csteber02/ECE-445/Final Project V1/CL21B105KBFNNNG/CL21B105KBFNNNG.step

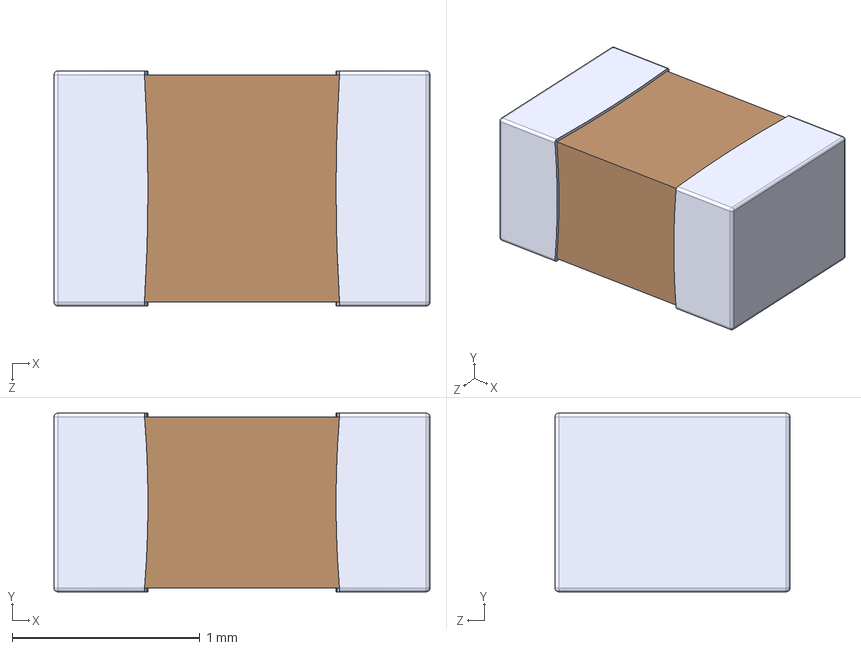
[picture p8: CAD file, 2025-02-24]
Final Project V1/CL21B105KBFNNNG/CL21B105KBFNNNG.step
2.00 x 0.95 x 1.25 mm
