csteber02/ECE-445/Final Project V1/Final Project V1.step

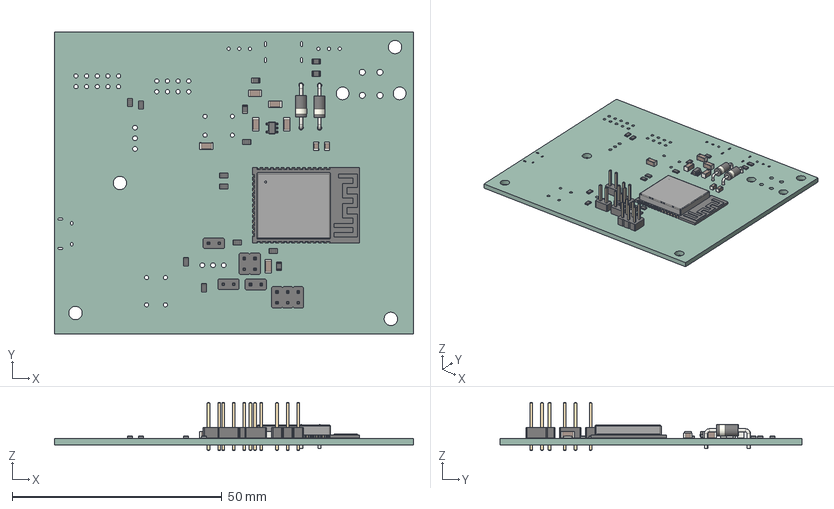
[picture p9: CAD file, 2025-04-11]
Final Project V1/Final Project V1.step
85.6 x 72.0 x 11.5 mm
D_DO-41_SOD81_P10.16mm_Horizontal x 2
R_0805_2012Metric x 14
ESP32-S3-WROOM-1
C_1206_3216Metric x 6
PinHeader_2x02_P254mm_Vertical
C_0805_2012Metric x 2
PinHeader_2x03_P254mm_Vertical
PinHeader_2x01_P254mm_Vertical x 3
SOT_23_5
Final Project V1_PCB
