csteber02/ECE-445/Final Project V1/UJC_HP_3_SMT_TR/UJC-HP-3-SMT-TR.step

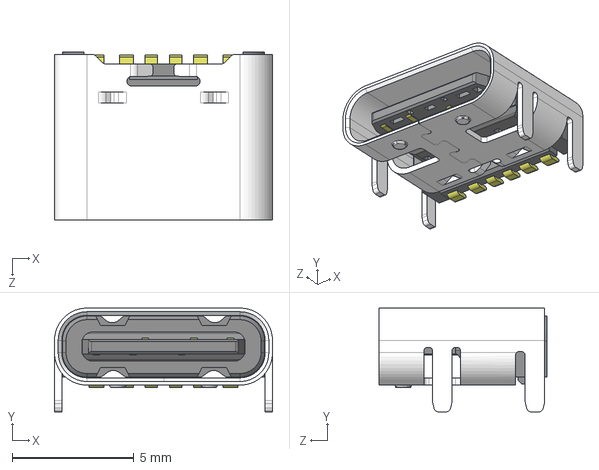
[picture p10: CAD file, 2025-02-27]
Final Project V1/UJC_HP_3_SMT_TR/UJC-HP-3-SMT-TR.step
8.94 x 4.26 x 6.90 mm
