csteber02/ECE-445/Final Project V1/Fish Feeder Rotator.stl

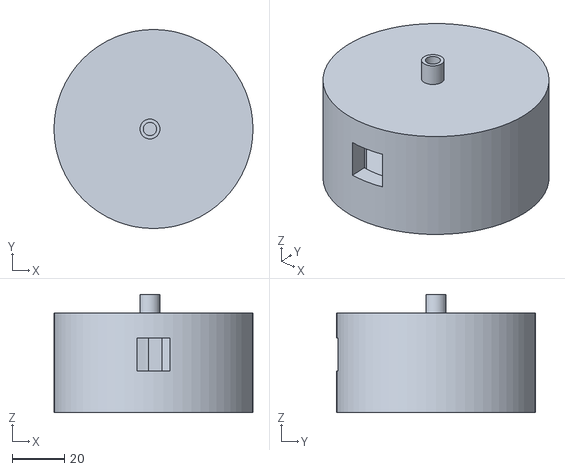
[picture p11: CAD file, 2025-03-10]
Final Project V1/Fish Feeder Rotator.stl
76.2 x 76.2 x 45.3
