csteber02/ECE-445/Final Project V1/10118194_0001LF/10118194-0001LF.step

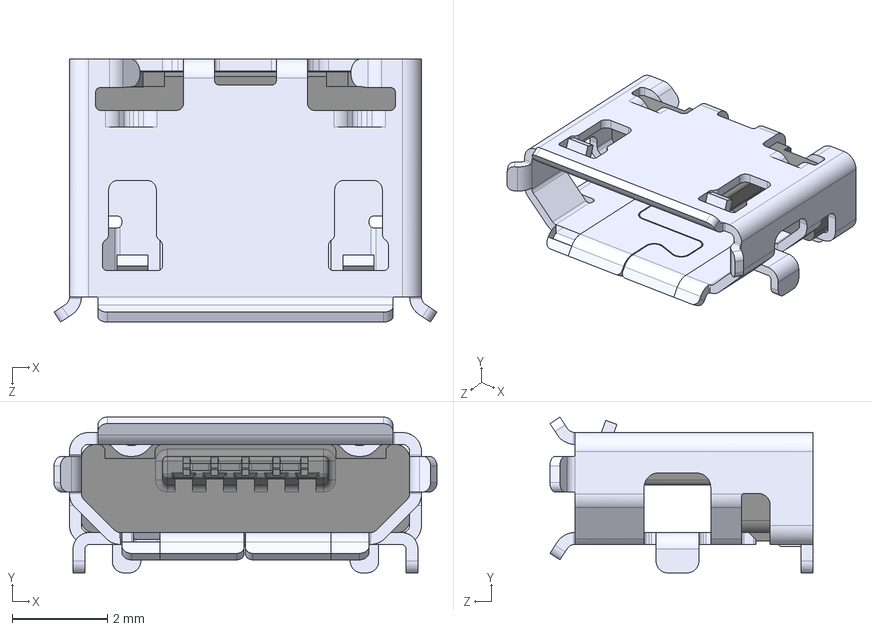
[picture p12: CAD file, 2025-04-11]
Final Project V1/10118194_0001LF/10118194-0001LF.step
8.05 x 3.27 x 5.53 mm
