csteber02/ECE-445/Final Project V1/1825910_6/1825910-6.step

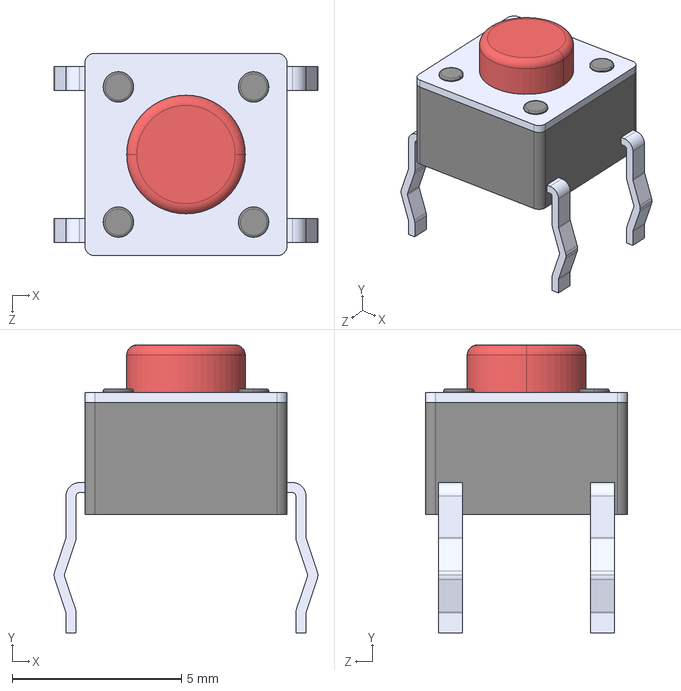
[picture p13: CAD file, 2025-03-10]
Final Project V1/1825910_6/1825910-6.step
7.80 x 8.52 x 5.99 mm
