csteber02/ECE-445/Final Project V1/75867_132LF/75867-132LF.step

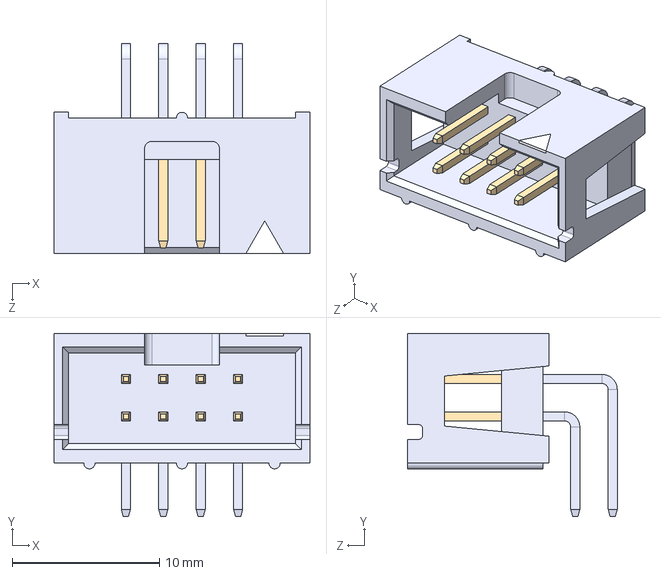
[picture p14: CAD file, 2025-03-28]
Final Project V1/75867_132LF/75867-132LF.step
17.4 x 12.5 x 14.2 mm
75867-xxxxLF_(Additional)_75867-132LF
Gold_Contact x 4
