csteber02/ECE-445/Final Project V1/BQ21040DBVR/BQ21040DBVR.step

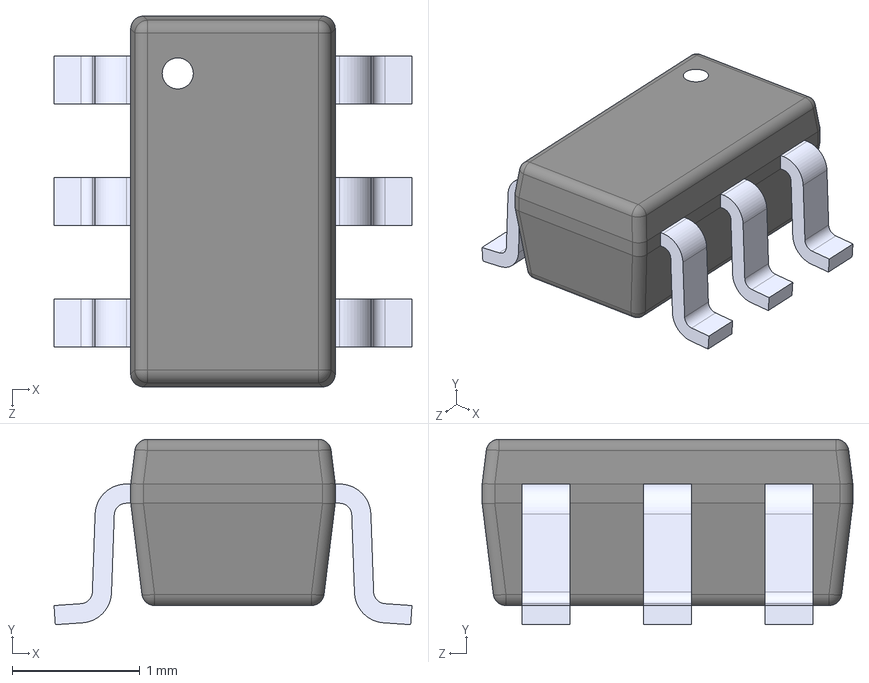
[picture p15: CAD file, 2025-02-27]
Final Project V1/BQ21040DBVR/BQ21040DBVR.step
2.80 x 1.45 x 2.90 mm
