csteber02/ECE-445/Final Project V1/TLV75533PDBVR/TLV75533PDBVR.step

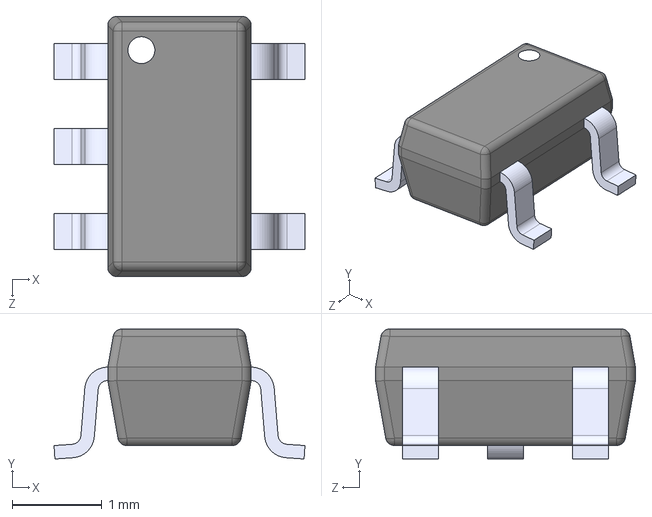
[picture p16: CAD file, 2025-02-24]
Final Project V1/TLV75533PDBVR/TLV75533PDBVR.step
2.80 x 1.45 x 2.90 mm
