csteber02/ECE-445/Lab Notebooks/Jeremy Notebook.pdf

1/27/2025

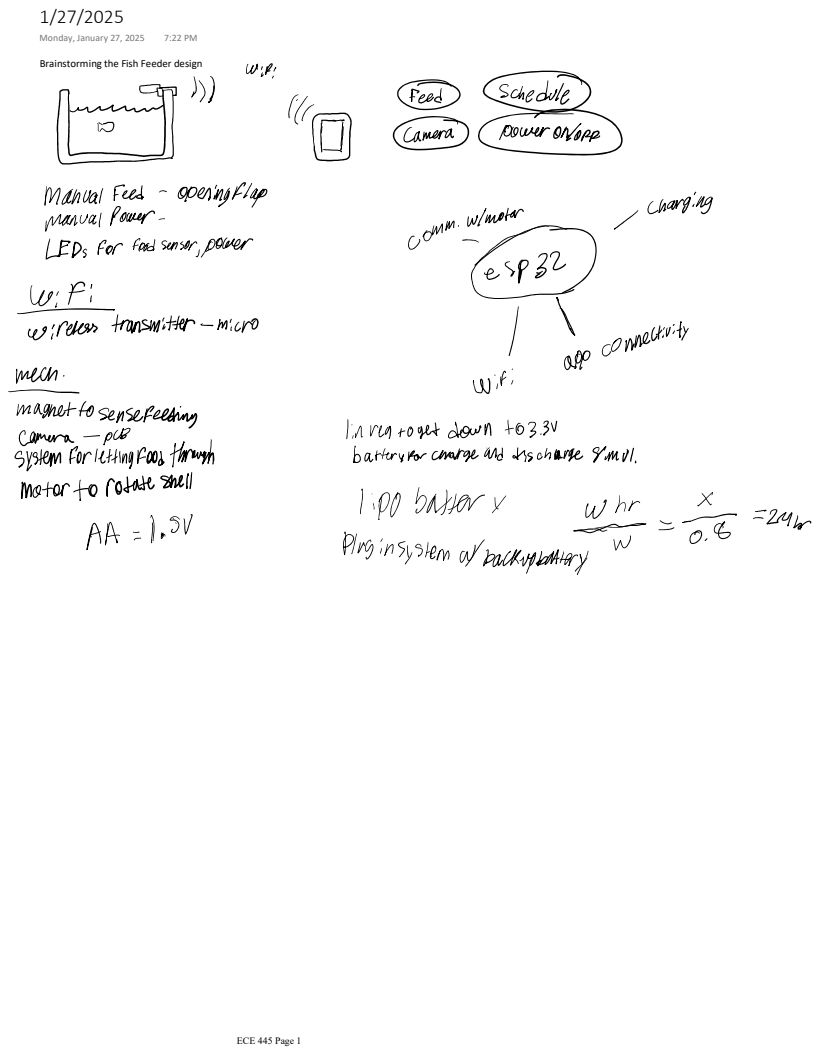
[picture p17: page 1]
Monday, January 27, 2025; ECE 445 Page 1

Brainstorming the Fish Feeder design

# 2/10/2025 - 5PM to 7PM

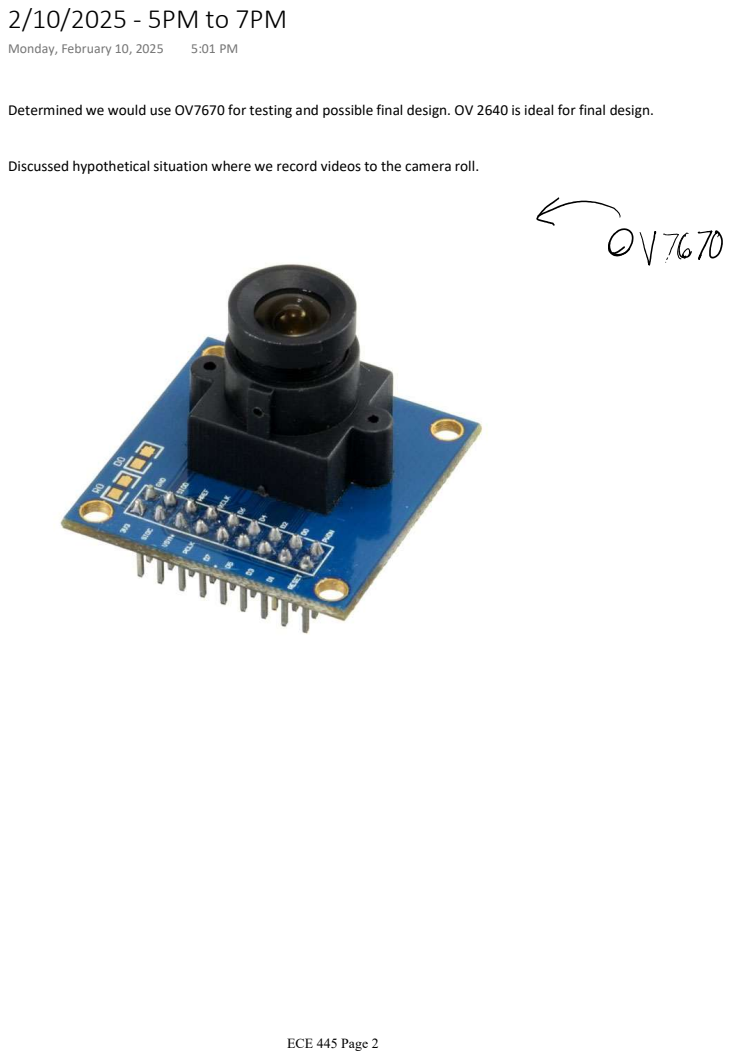
[picture p18: page 2]
Monday, February 10, 2025; ECE 445 Page 2

Determined we would use OV7670 for testing and possible final design. OV 2640 is ideal for final design.

Discussed hypothetical situation where we record videos to the camera roll.

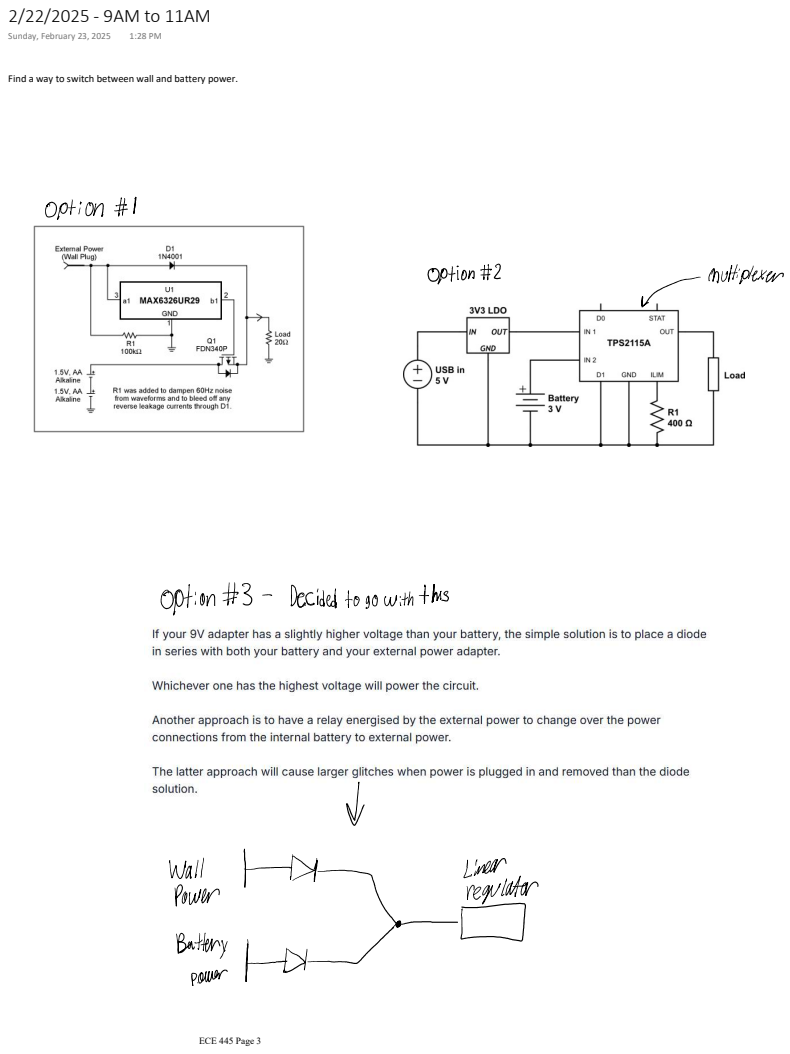
[picture p19: page 3]
Sunday, February 23, 2025; ECE 445 Page 3

Find a way to switch between wall and battery power.

2/23/2025 - 1:30 to 2:45

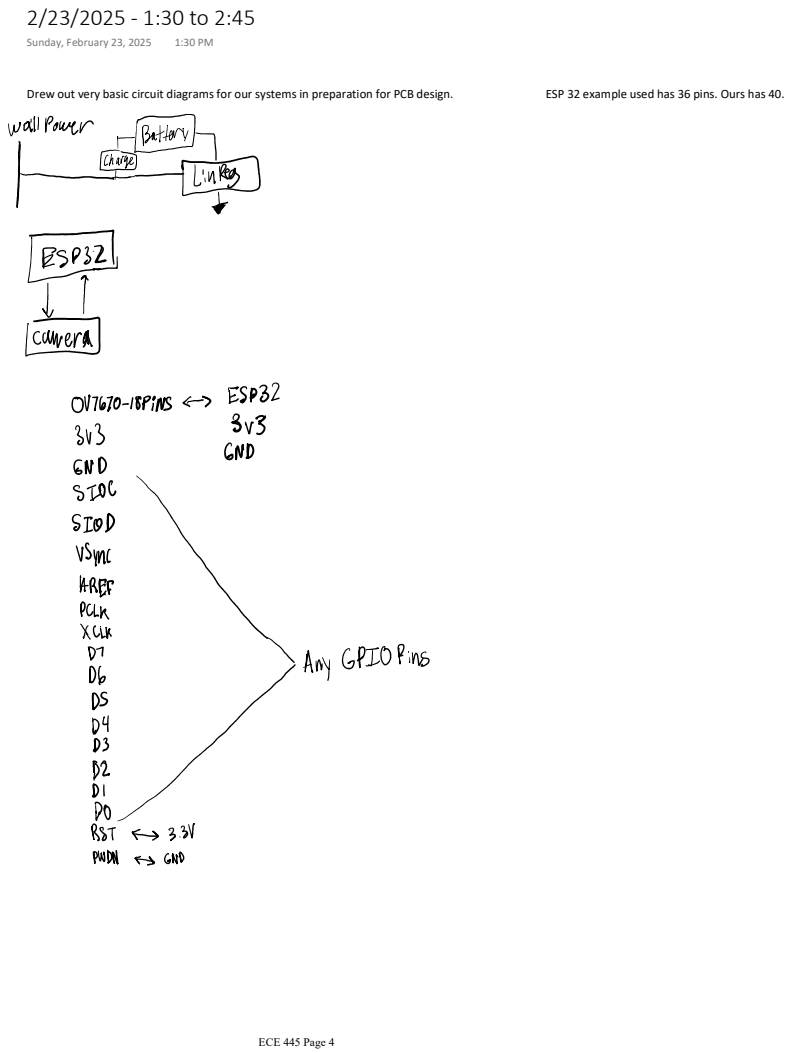
[picture p20: page 4]
Drew out very basic circuit diagrams for our systems in preparation for PCB design.; ESP 32 example used has 36 pins. Ours has 40.; Sunday, February 23, 2025; ECE 445 Page 4

## 2/24/25 - 5PM to 7PM

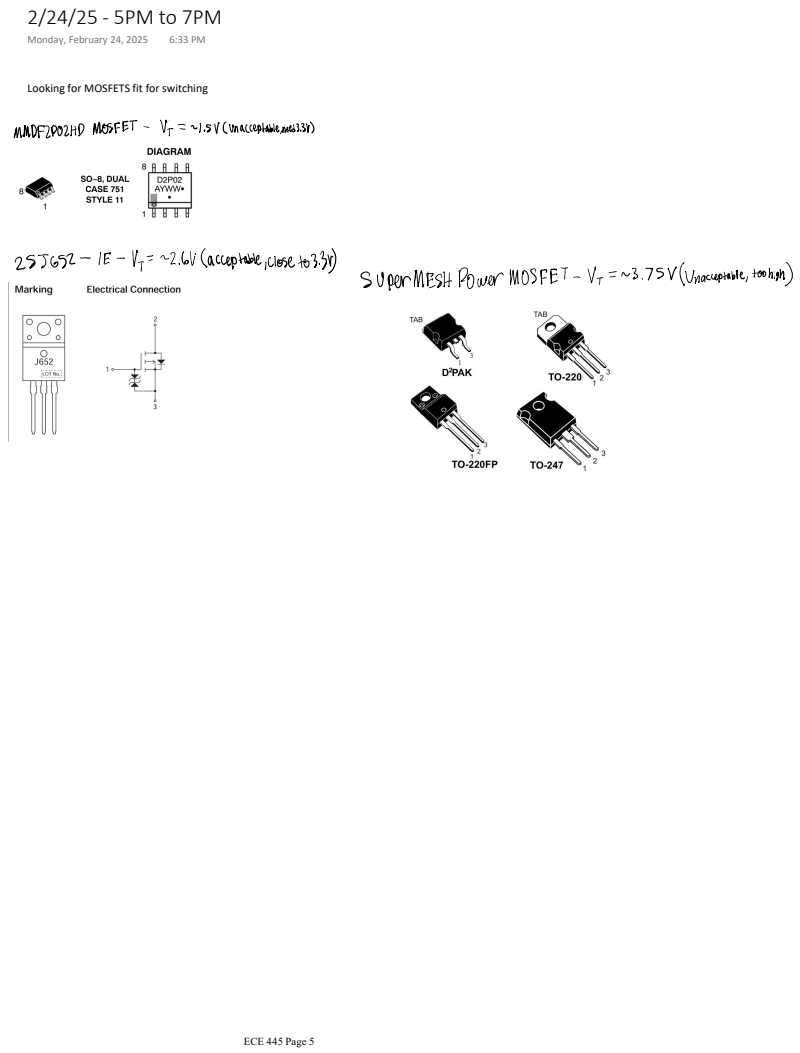
[picture p21: page 5]
Monday, February 24, 2025; ECE 445 Page 5

Looking for MOSFETS fit for switching

## 2/28/25 2PM-7:30PM

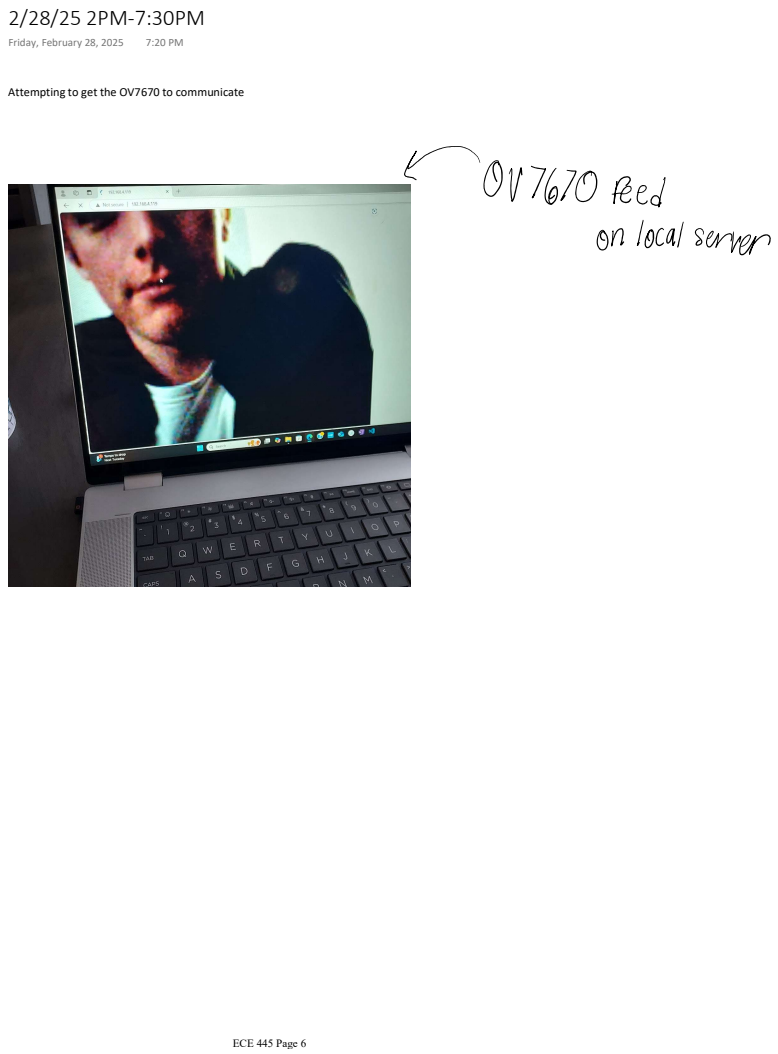
[picture p22: page 6]
Friday, February 28, 2025; ECE 445 Page 6

Attempting to get the OV7670 to communicate

3/24/2025 - 4:00-8:30PM

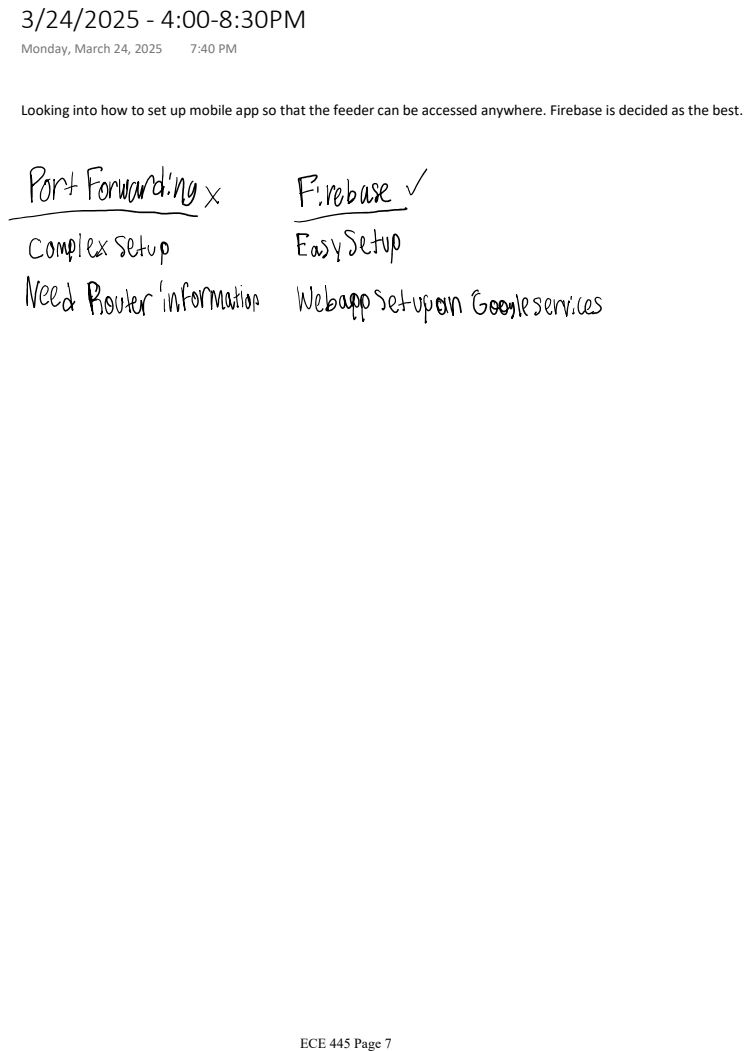
[picture p23: page 7]
Monday, March 24, 2025; ECE 445 Page 7

Looking into how to set up mobile app so that the feeder can be accessed anywhere. Firebase is decided as the best.

## 3/26/2025 5PM-9:30PM

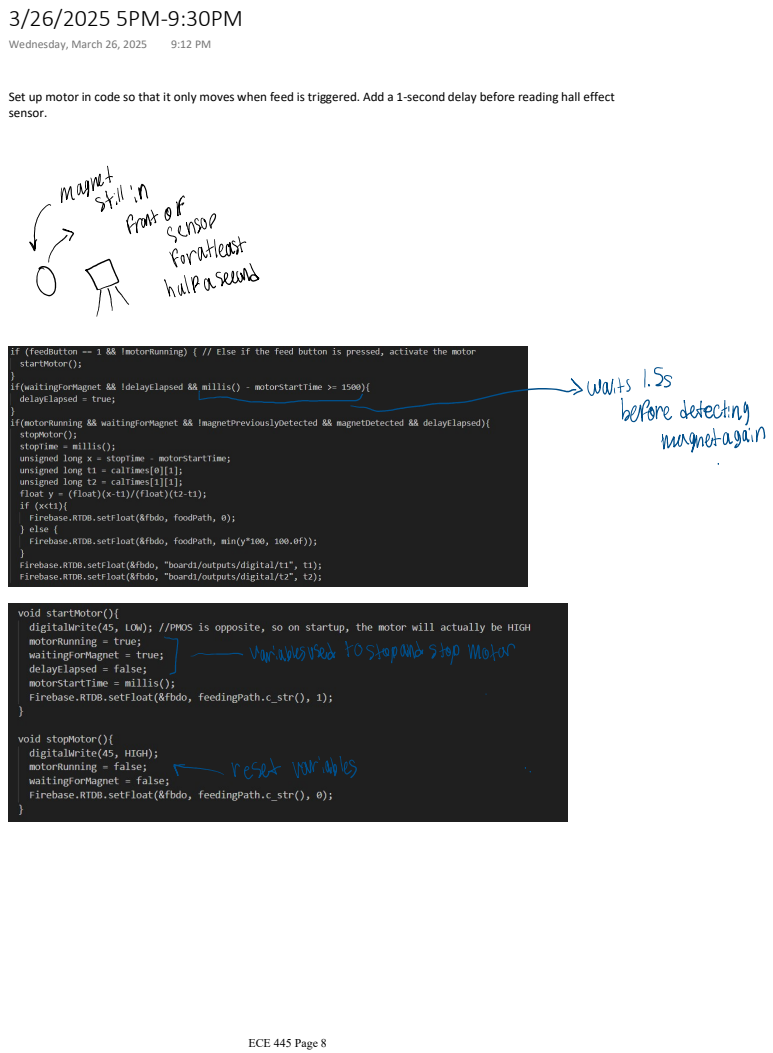
[picture p24: page 8]
Wednesday, March 26, 2025; ECE 445 Page 8

Set up motor in code so that it only moves when feed is triggered. Add a 1-second delay before reading hall effect
sensor.

# 3/27/2025 4:30PM-8PM

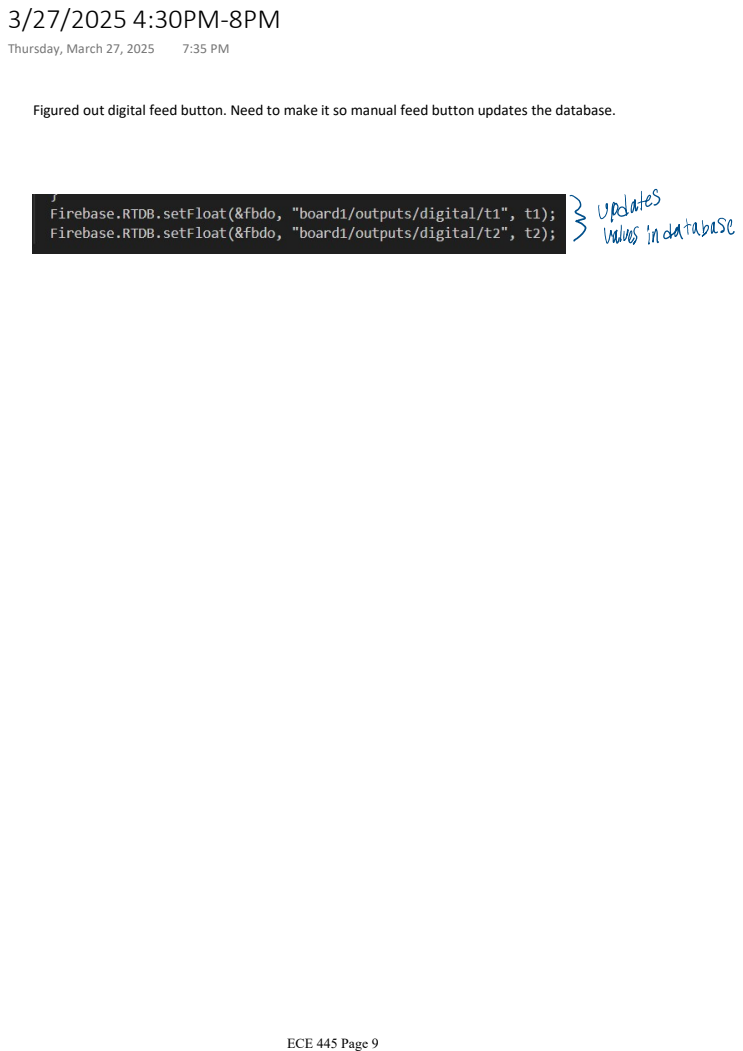
[picture p25: page 9]
Thursday, March 27, 2025; ECE 445 Page 9

Figured out digital feed button. Need to make it so manual feed button updates the database.

4/20/25

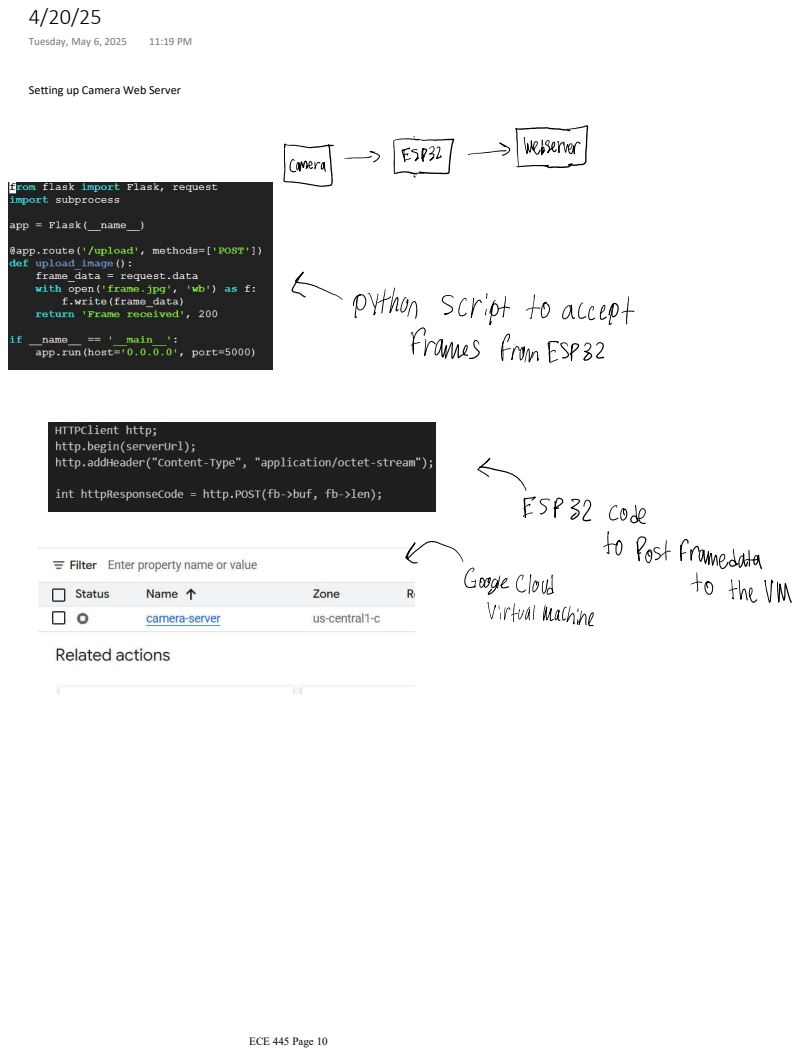
[picture p26: page 10]
Tuesday, May 6, 2025; ECE 445 Page 10

Setting up Camera Web Server

4/25/2023

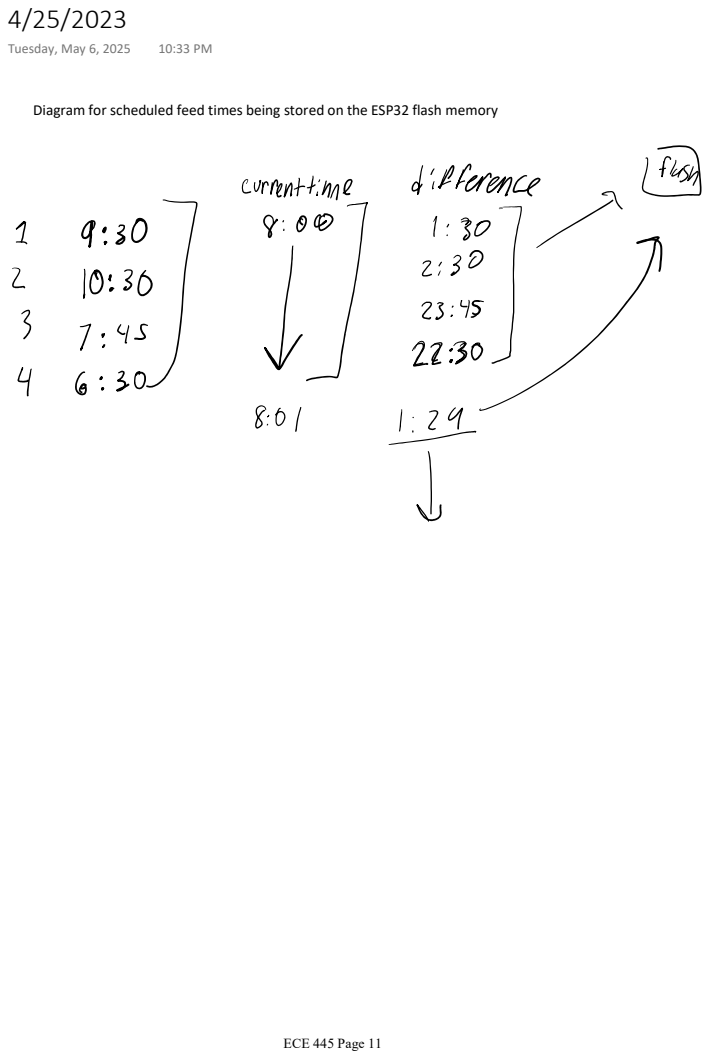
[picture p27: page 11]
Tuesday, May 6, 2025; ECE 445 Page 11

Diagram for scheduled feed times being stored on the ESP32 flash memory

4/26/2025

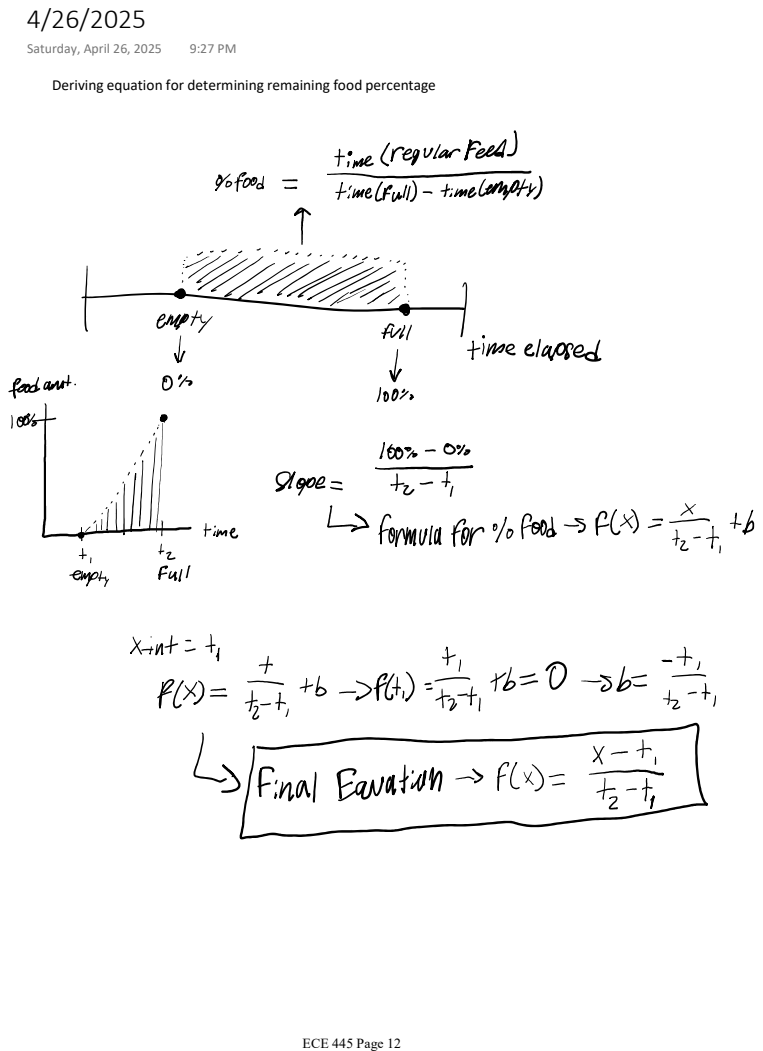
[picture p28: page 12]
Saturday, April 26, 2025; ECE 445 Page 12

Deriving equation for determining remaining food percentage
