csteber02/ECE-445/Final Project V1/Final Project V1.kicad_pcb

## KiCad design Final Project V1/Final Project V1.kicad_pcb (2025-04-11)

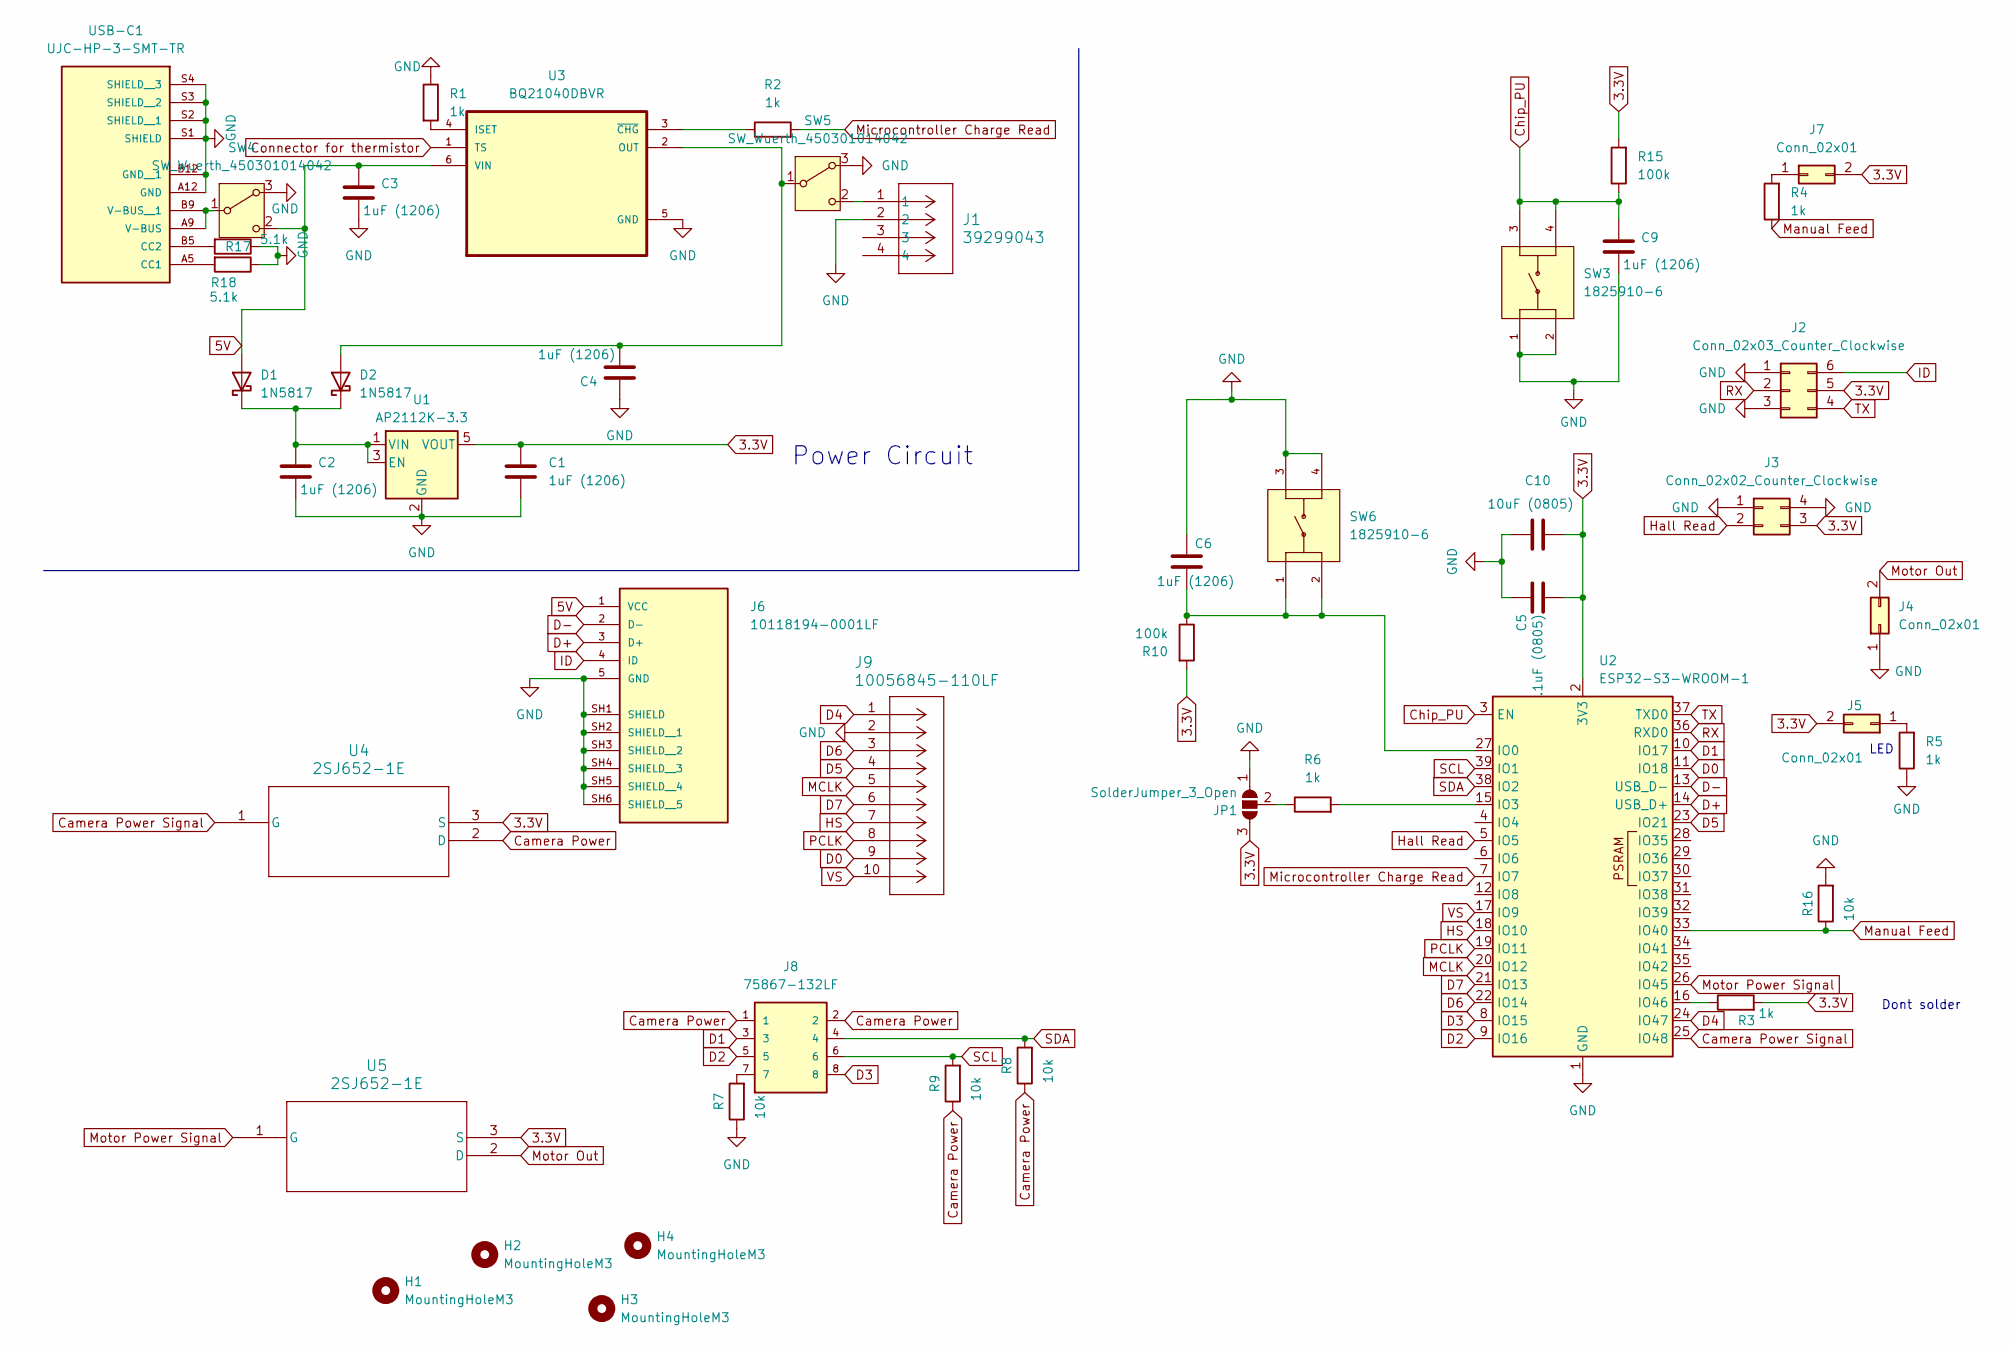
[picture p29: schematic Final Project V1.kicad_sch]

Parts:
C1, C2, C3, C4, C6, C9: 1uF (1206); C_1206_3216Metric_Pad1.33x1.80mm_HandSolder
C5: .1uF (0805); C_0805_2012Metric_Pad1.18x1.45mm_HandSolder
C10: 10uF (0805); C_0805_2012Metric_Pad1.18x1.45mm_HandSolder
D1, D2: 1N5817; D_DO-41_SOD81_P10.16mm_Horizontal
H1, H2, H3, H4: MountingHoleM3; MountingHole_3.2mm_M3_DIN965
J1: 39299043; CONN_5566-04x2_MOL
J2: Conn_02x03_Counter_Clockwise; PinHeader_2x03_P2.54mm_Vertical
J3: Conn_02x02_Counter_Clockwise; PinHeader_2x02_P2.54mm_Vertical
J4, J5, J7: Conn_02x01; PinHeader_2x01_P2.54mm_Vertical
J6: 10118194-0001LF; AMPHENOL_10118194-0001LF; PARTREV D
J8: 75867-132LF; HDRRA8W62P254_4X2_1737X957H920; MPN 75867-132LF
J9: 10056845-110LF; CON10_2X5_R2_FCI_GLE
JP1: SolderJumper_3_Open; SolderJumper-3_P2.0mm_Open_TrianglePad1.0x1.5mm
R1, R2, R3, R4, R5, R6: 1k; R_0805_2012Metric_Pad1.20x1.40mm_HandSolder
R7, R8, R9, R16: 10k; R_0805_2012Metric_Pad1.20x1.40mm_HandSolder
R10, R15: 100k; R_0805_2012Metric_Pad1.20x1.40mm_HandSolder
R17, R18: 5.1k; R_0805_2012Metric_Pad1.20x1.40mm_HandSolder
SW3, SW6: 1825910-6; SW_1825910-6-4; PARTREV C10
SW4, SW5: SW_Wuerth_450301014042; SW_Slide-03_Wuerth-WS-SLTV_10x2.5x6.4_P2.54mm
U1: AP2112K-3.3; SOT-23-5
U2: ESP32-S3-WROOM-1
U3: BQ21040DBVR; SOT95P280X145-6N
U4, U5: 2SJ652-1E; TO-220F-3SG_15P87X10P16_ONS
USB-C1: UJC-HP-3-SMT-TR; CUI_UJC-HP-3-SMT-TR; PARTREV 04/30/2020

Connections:
3.3V: C1.1, C5.2, C10.2, J2.5, J3.3, J5.2, J7.2, JP1.3 (B), R3.2, R10.2, R15.2, U1.5 (VOUT), U2.2 (3V3), U4.3 (S), U5.3 (S)
5V: C3.1, D1.2 (A), J6.1 (VCC), SW4.2 (C), U3.6 (VIN)
Camera Power: J8.1, J8.2, R8.1, R9.1, U4.2 (D)
Camera Power Signal: U2.25 (IO48), U4.1 (G)
Chip_PU: C9.1, R15.1, SW3.3, SW3.4, U2.3 (EN)
Connector for thermistor: U3.1 (TS)
D0: J9.9, U2.11 (IO18)
D1: J8.3, U2.10 (IO17)
D2: J8.5, U2.9 (IO16)
D3: J8.8, U2.8 (IO15)
D4: J9.1, U2.24 (IO47)
D5: J9.4, U2.23 (IO21)
D6: J9.3, U2.22 (IO14)
D7: J9.6, U2.21 (IO13)
D+: J6.3 (D+), U2.14 (USB_D+)
D-: J6.2 (D-), U2.13 (USB_D-)
GND: C1.2, C2.2, C3.2, C4.1, C5.1, C6.1, C9.2, C10.1, J1.2, J2.1, J2.3, J3.1, J3.4, J4.1, J6.5 (GND), J6.SH1 (SHIELD), J6.SH2 (SHIELD__1), J6.SH3 (SHIELD__2), J6.SH4 (SHIELD__3), J6.SH5 (SHIELD__4), J6.SH6 (SHIELD__5), J9.2, JP1.1 (A), R1.1, R5.1, R7.1, R16.2, R17.1, R18.1, SW3.1, SW3.2, SW4.3 (A), SW5.3 (A), SW6.3, SW6.4, U1.2 (GND), U2.1 (GND), U2.40 (GND), U2.41 (GND), U3.5 (GND), USB-C1.A12 (GND), USB-C1.B12 (GND__1), USB-C1.S1 (SHIELD), USB-C1.S2 (SHIELD__1), USB-C1.S3 (SHIELD__2), USB-C1.S4 (SHIELD__3)
HS: J9.7, U2.18 (IO10)
Hall Read: J3.2, U2.5 (IO5)
ID: J2.6, J6.4 (ID)
MCLK: J9.5, U2.20 (IO12)
Manual Feed: R4.1, R16.1, U2.33 (IO40)
Microcontroller Charge Read: R2.2, U2.7 (IO7)
Motor Out: J4.2, U5.2 (D)
Motor Power Signal: U2.26 (IO45), U5.1 (G)
unnamed: C2.1, D1.1 (K), D2.1 (K), U1.1 (VIN), U1.3 (EN)
unnamed: C4.2, D2.2 (A), SW5.1 (B), U3.2 (OUT)
unnamed: J5.1, R5.2
unnamed: J7.1, R4.2
unnamed: J8.7, R7.2
unnamed: JP1.2 (C), R6.1
unnamed: SW4.1 (B), USB-C1.A9 (V-BUS), USB-C1.B9 (V-BUS__1)
unnamed: J1.1, SW5.2 (C)
unnamed: C6.2, R10.1, SW6.1, SW6.2, U2.27 (IO0)
unnamed: R6.2, U2.15 (IO3)
unnamed: R3.1, U2.16 (IO46)
unnamed: R1.2, U3.4 (ISET)
unnamed: R2.1, U3.3 (~CHG)
unnamed: R18.2, USB-C1.A5 (CC1)
unnamed: R17.2, USB-C1.B5 (CC2)
PCLK: J9.8, U2.19 (IO11)
RX: J2.2, U2.36 (RXD0)
SCL: J8.6, R9.2, U2.39 (IO1)
SDA: J8.4, R8.2, U2.38 (IO2)
TX: J2.4, U2.37 (TXD0)
VS: J9.10, U2.17 (IO9)

Notes on the sheet:
Dont solder
LED
Power Circuit

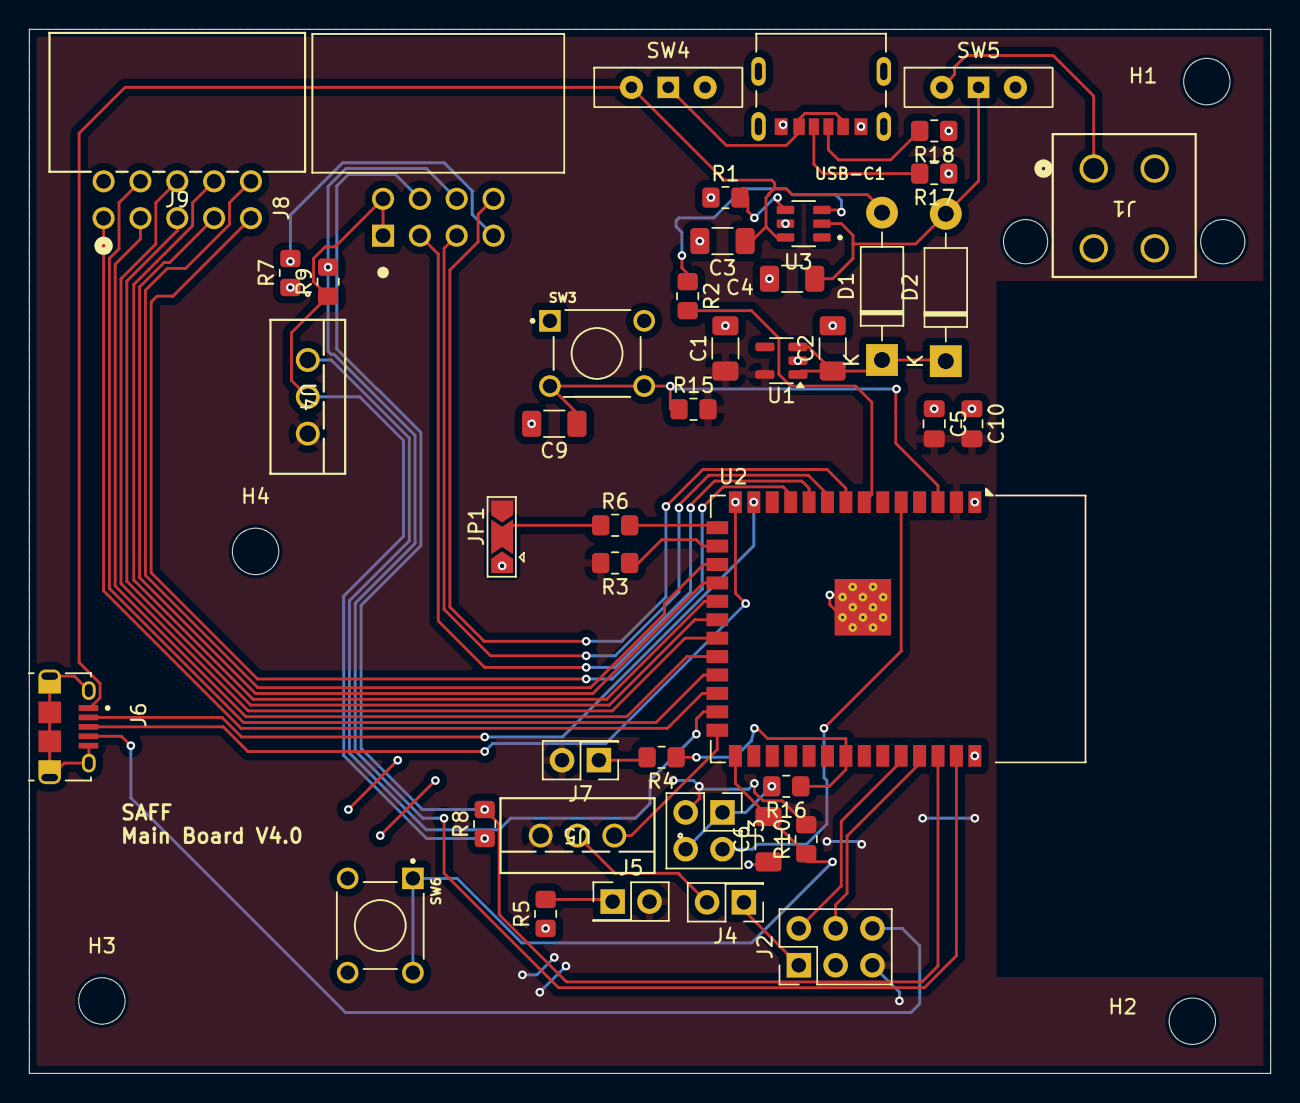
[picture p30: board Final Project V1.kicad_pcb from above]

Board: 2 copper layers, 85.6 x 72.0 mm, 48 parts (0 on the bottom side), 45 nets.
