csteber02/ECE-445/esp32_example_rev_A/esp32_example.kicad_pcb

## KiCad design esp32_example_rev_A/esp32_example.kicad_pcb (2025-02-27)

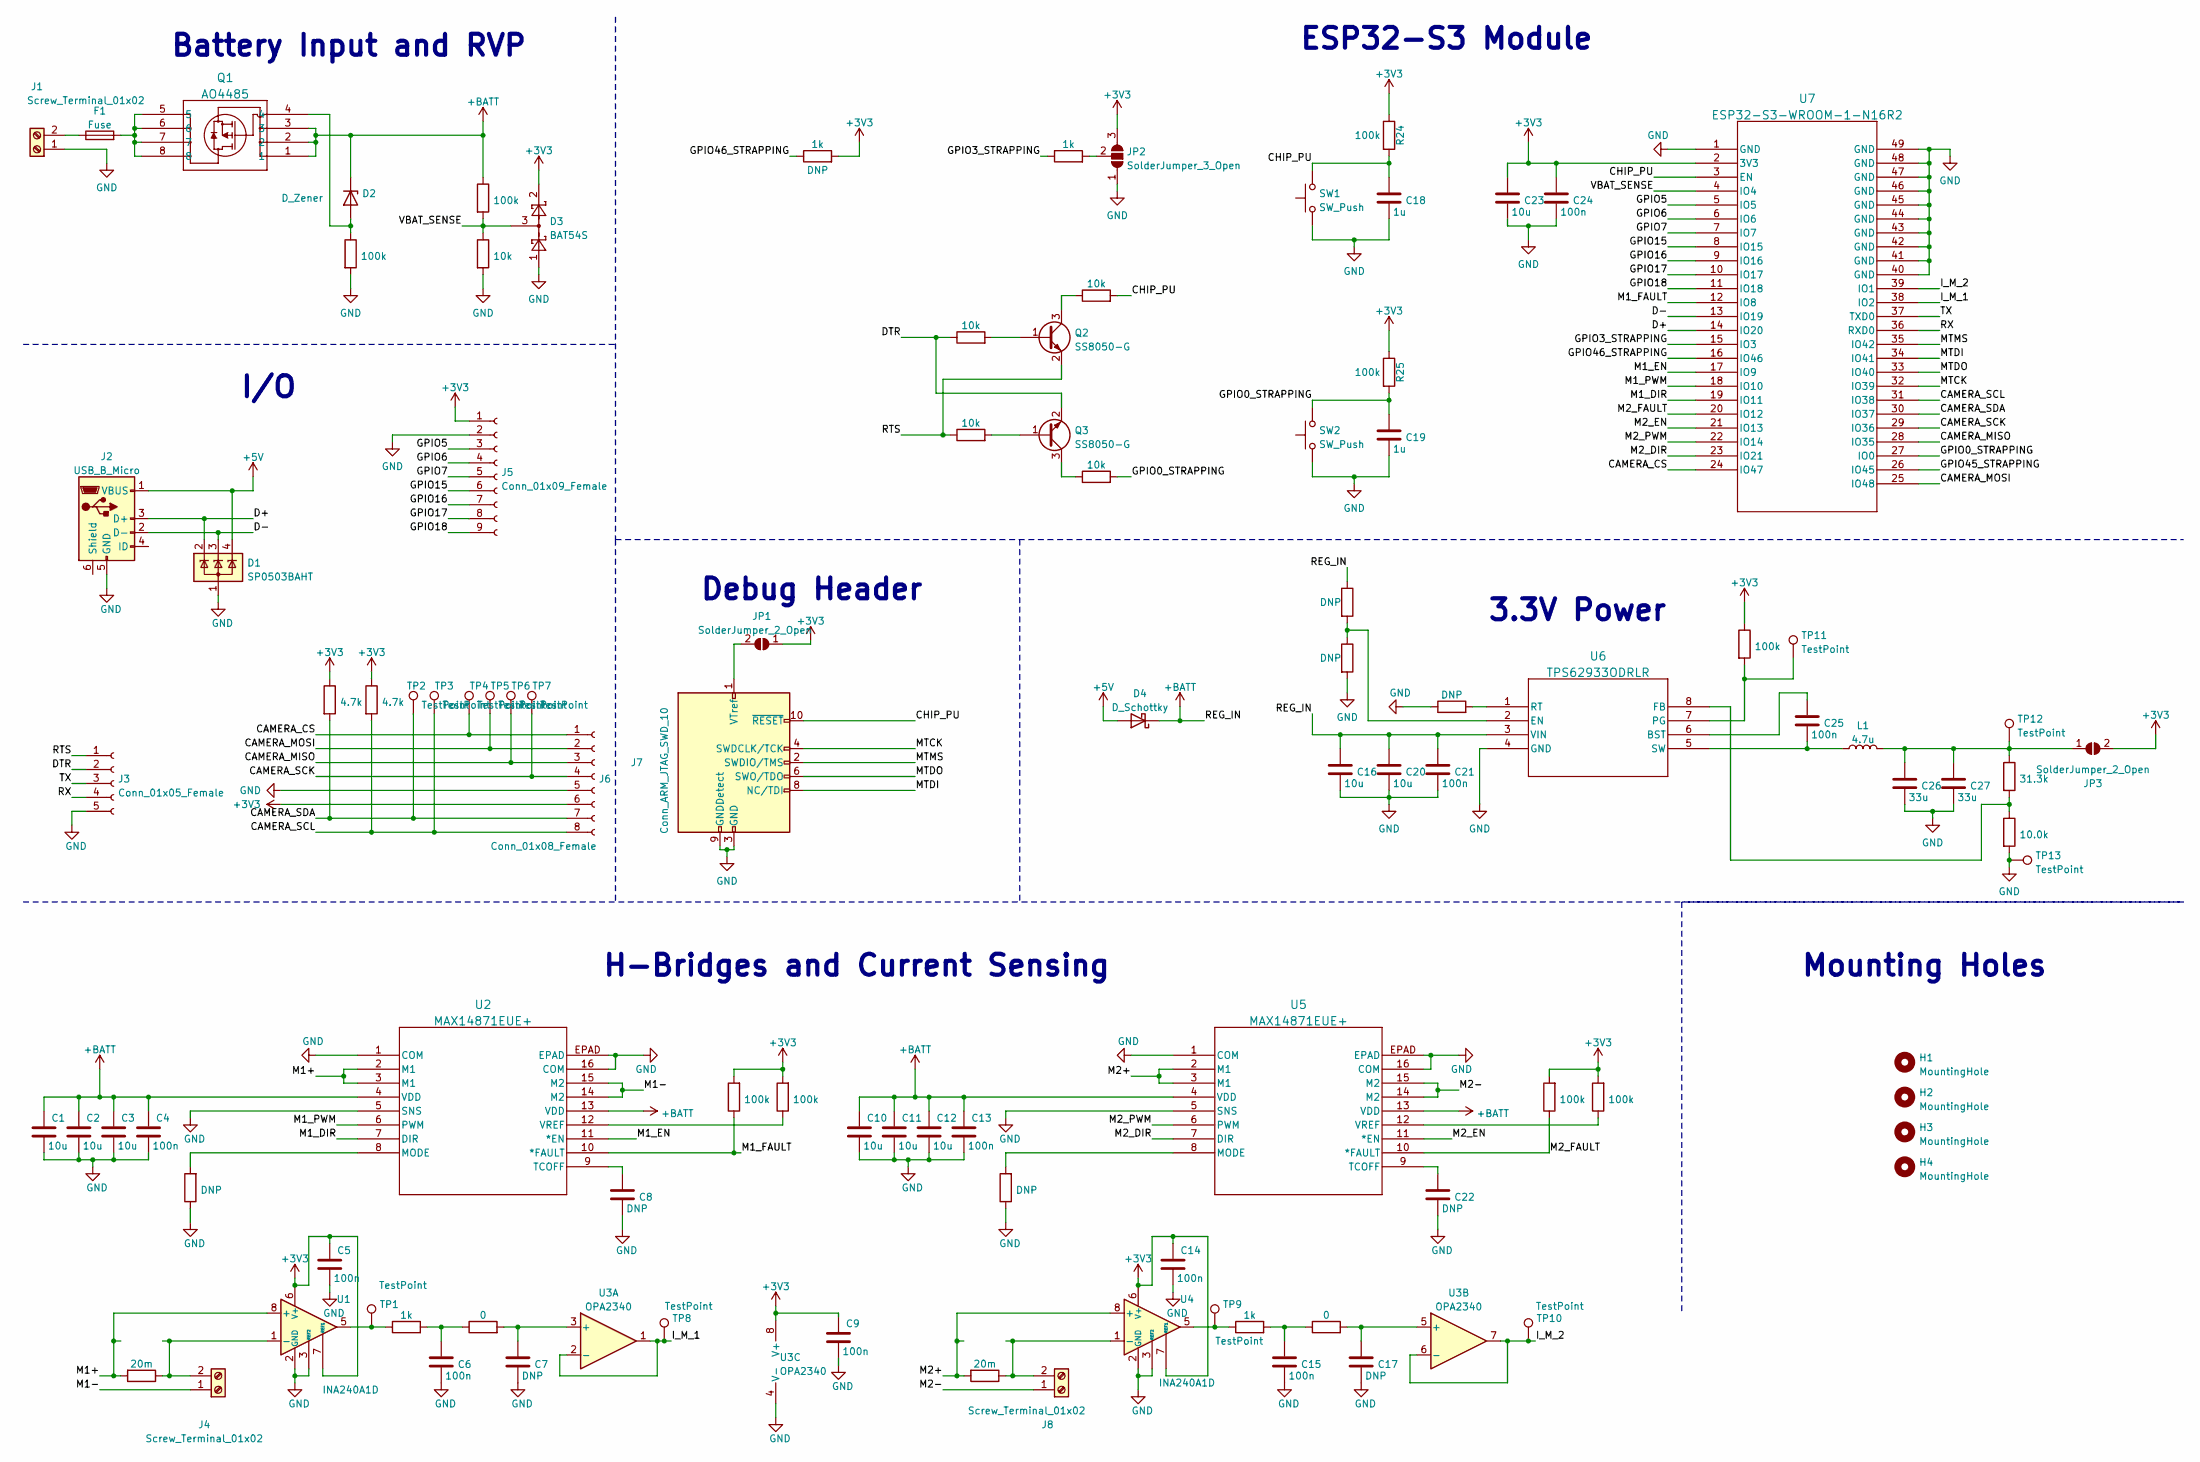
[picture p31: schematic esp32_example.kicad_sch, ESP32 Example: Motor Controller]

Parts:
C1, C2, C3, C10, C11, C12: 10u; R_1206_3216Metric
C4, C5, C6, C9, C13, C14, C15, C21, C24, C25: 100n; C_0805_2012Metric
C7, C8, C17, C22: DNP; C_0805_2012Metric
C16, C20, C23: 10u; C_0805_2012Metric
C18, C19: 1u; C_0805_2012Metric
C26, C27: 33u; C_0805_2012Metric
D1: SP0503BAHT; SOT-143
D2: D_Zener; SOD-123_ONS
D3: BAT54S; SOT-23
D4: D_Schottky; D_SMA
F1: Fuse; Fuseholder_Littelfuse_Nano2_154x
H1, H2, H3, H4: MountingHole; MountingHole_3.2mm_M3
J1, J4, J8: Screw_Terminal_01x02; TerminalBlock_Phoenix_MKDS-1,5-2-5.08_1x02_P5.08mm_Horizont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
J2: USB_B_Micro; USB_Micro-B_Amphenol_10118194_Horizontal
J3: Conn_01x05_Female; PinHeader_1x05_P2.54mm_Vertical
J5: Conn_01x09_Female; PinHeader_1x09_P2.54mm_Vertical
J6: Conn_01x08_Female; PinHeader_1x08_P2.54mm_Vertical
J7: Conn_ARM_JTAG_SWD_10; IDC-Header_2x05_P2.54mm_Vertical
JP1, JP3: SolderJumper_2_Open; SolderJumper-2_P1.3mm_Open_TrianglePad1.0x1.5mm
JP2: SolderJumper_3_Open; SolderJumper-3_P2.0mm_Open_TrianglePad1.0x1.5mm
L1: 4.7u; L_Taiyo-Yuden_NR-60xx
Q1: AO4485; SO8SOP-8L_AOS
Q2, Q3: SS8050-G; SOT-23
R1, R15: 20m; R_1206_3216Metric
R2, R16, R22, R23, R26: DNP; R_0805_2012Metric
R3, R4: 4.7k; R_0805_2012Metric
R5, R12, R17, R20: 1k; R_0805_2012Metric
R6, R8, R10, R11, R24, R25, R27, R28, R29: 100k; R_0805_2012Metric
R7, R21: 0; R_0805_2012Metric
R9, R13, R14, R18, R19: 10k; R_0805_2012Metric
R30: 31.3k; R_0805_2012Metric
R31: 10.0k; R_0805_2012Metric
SW1, SW2: SW_Push; SW_SPST_B3S-1000
TP1, TP2, TP3, TP4, TP5, TP6, TP7, TP8, TP9, TP10, TP12, TP13: TestPoint; TestPoint_Keystone_5010-5014_Multipurpose
TP11: TestPoint; TestPoint_Pad_D2.0mm
U1, U4: INA240A1D; SOIC-8_3.9x4.9mm_P1.27mm
U2, U5: MAX14871EUE+; 21-0108_U16E&plus_3_MXM
U3: OPA2340; SOIC-8_3.9x4.9mm_P1.27mm
U6: TPS62933ODRLR; SOT5X3-8_DRL_TEX
U7: ESP32-S3-WROOM-1-N16R2; ESP32-S3-WROOM-1_EXP

Connections:
+3V3: C5.1, C9.1, C14.1, C23.1, C24.1, D3.2, J5.1, J6.6, JP1.1 (A), JP2.3 (B), JP3.2 (B), R3.1, R4.1, R10.2, R11.2, R12.2, R24.1, R25.1, R27.2, R28.2, R29.1, U1.6 (V+), U1.7 (REF1), U3.8 (V+), U4.6 (V+), U4.7 (REF1), U7.2 (3V3)
+5V: D1.4 (K), D4.2 (A), J2.1 (VBUS)
+BATT: C1.1, C2.1, C3.1, C4.1, C10.1, C11.1, C12.1, C13.1, C16.1, C20.1, C21.1, D2.1 (K), D4.1 (K), Q1.1, Q1.2, Q1.3, R8.1, R22.1, U2.4 (VDD), U2.13 (VDD), U5.4 (VDD), U5.13 (VDD), U6.3 (VIN)
/CAMERA_CS: J6.1, TP4.1, U7.24 (IO47)
/CAMERA_MISO: J6.3, TP6.1, U7.28 (IO35)
/CAMERA_MOSI: J6.2, TP5.1, U7.25 (IO48)
/CAMERA_SCK: J6.4, TP7.1, U7.29 (IO36)
/CAMERA_SCL: J6.8, R4.2, TP3.1, U7.31 (IO38)
/CAMERA_SDA: J6.7, R3.2, TP2.1, U7.30 (IO37)
/CHIP_PU: C18.1, J7.10 (~RESET), R18.2, R24.2, SW1.2, U7.3 (EN)
/D+: D1.2 (K), J2.3 (D+), U7.14 (IO20)
/D-: D1.3 (K), J2.2 (D-), U7.13 (IO19)
/DTR: J3.2, Q3.2 (E), R13.1
/GPIO0_STRAPPING: C19.1, R19.2, R25.2, SW2.2, U7.27 (IO0)
/GPIO3_STRAPPING: R17.1, U7.15 (IO3)
/GPIO5: J5.3, U7.5 (IO5)
/GPIO6: J5.4, U7.6 (IO6)
/GPIO7: J5.5, U7.7 (IO7)
/GPIO15: J5.6, U7.8 (IO15)
/GPIO16: J5.7, U7.9 (IO16)
/GPIO17: J5.8, U7.10 (IO17)
/GPIO18: J5.9, U7.11 (IO18)
/GPIO45_STRAPPING: U7.26 (IO45)
/GPIO46_STRAPPING: R12.1, U7.16 (IO46)
/I_M_1: TP8.1, U3.1, U3.2 (-), U7.38 (IO2)
/I_M_2: TP10.1, U3.6 (-), U3.7, U7.39 (IO1)
/M1+: R1.2, U1.8 (+), U2.2 (M1), U2.3 (M1)
/M1-: J4.1, U2.14 (M2), U2.15 (M2)
/M1_DIR: U2.7 (DIR), U7.19 (IO11)
/M1_EN: U2.11 (*EN), U7.17 (IO9)
/M1_FAULT: R10.1, U2.10 (*FAULT), U7.12 (IO8)
/M1_PWM: U2.6 (PWM), U7.18 (IO10)
/M2+: R15.2, U4.8 (+), U5.2 (M1), U5.3 (M1)
/M2-: J8.1, U5.14 (M2), U5.15 (M2)
/M2_DIR: U5.7 (DIR), U7.23 (IO21)
/M2_EN: U5.11 (*EN), U7.21 (IO13)
/M2_FAULT: R27.1, U5.10 (*FAULT), U7.20 (IO12)
/M2_PWM: U5.6 (PWM), U7.22 (IO14)
/MTCK: J7.4 (SWDCLK/TCK), U7.32 (IO39)
/MTDI: J7.8 (NC/TDI), U7.34 (IO41)
/MTDO: J7.6 (SWO/TDO), U7.33 (IO40)
/MTMS: J7.2 (SWDIO/TMS), U7.35 (IO42)
/RTS: J3.1, Q2.2 (E), R14.1
/RX: J3.4, U7.36 (RXD0)
/TX: J3.3, U7.37 (TXD0)
/VBAT_SENSE: D3.3, R8.2, R9.1, U7.4 (IO4)
GND: C1.2, C2.2, C3.2, C4.2, C5.2, C6.2, C7.2, C8.2, C9.2, C10.2, C11.2, C12.2, C13.2, C14.2, C15.2, C16.2, C17.2, C18.2, C19.2, C20.2, C21.2, C22.2, C23.2, C24.2, C26.2, C27.2, D1.1 (A), D3.1, J1.1, J2.5 (GND), J3.5, J5.2, J6.5, J7.3 (GND), J7.5 (GND), J7.9 (GNDDetect), JP2.1 (A), R2.1, R6.2, R9.2, R16.1, R23.2, R26.1, R31.2, SW1.1, SW2.1, TP13.1, U1.2 (GND), U1.3 (REF2), U1.4 (GND), U2.1 (COM), U2.5 (SNS), U2.16 (COM), U2.EPAD, U3.4 (V-), U4.2 (GND), U4.3 (REF2), U4.4 (GND), U5.1 (COM), U5.5 (SNS), U5.16 (COM), U5.EPAD, U6.4 (GND), U7.1 (GND), U7.40 (GND), U7.41 (GND), U7.42 (GND), U7.43 (GND), U7.44 (GND), U7.45 (GND), U7.46 (GND), U7.47 (GND), U7.48 (GND), U7.49 (GND)
unnamed: C6.1, R5.2, R7.1
unnamed: C7.1, R7.2, U3.3 (+)
unnamed: C8.1, U2.9 (TCOFF)
unnamed: C15.1, R20.2, R21.1
unnamed: C17.1, R21.2, U3.5 (+)
unnamed: C22.1, U5.9 (TCOFF)
unnamed: C25.1, U6.6 (BST)
unnamed: C25.2, L1.1, U6.5 (SW)
unnamed: C26.1, C27.1, JP3.1 (A), L1.2, R30.1, TP12.1
unnamed: D2.2 (A), Q1.4, R6.1
unnamed: F1.1, J1.2
unnamed: F1.2, Q1.5, Q1.6, Q1.7, Q1.8
unnamed: J4.2, R1.1, U1.1 (-)
unnamed: J7.1 (VTref), JP1.2 (B)
unnamed: J8.2, R15.1, U4.1 (-)
unnamed: JP2.2 (C), R17.2
unnamed: Q2.1 (B), R13.2
unnamed: Q2.3 (C), R18.1
unnamed: Q3.1 (B), R14.2
unnamed: Q3.3 (C), R19.1
unnamed: R2.2, U2.8 (MODE)
unnamed: R5.1, TP1.1, U1.5
unnamed: R11.1, U2.12 (VREF)
unnamed: R16.2, U5.8 (MODE)
unnamed: R20.1, TP9.1, U4.5
unnamed: R22.2, R23.1, U6.2 (EN)
unnamed: R26.2, U6.1 (RT)
unnamed: R28.1, U5.12 (VREF)
unnamed: R29.2, TP11.1, U6.7 (PG)
unnamed: R30.2, R31.1, U6.8 (FB)

Notes on the sheet:
H-Bridges and Current Sensing
ESP32-S3 Module
Debug Header
Mounting Holes
3.3V Power
Battery Input and RVP
I/O

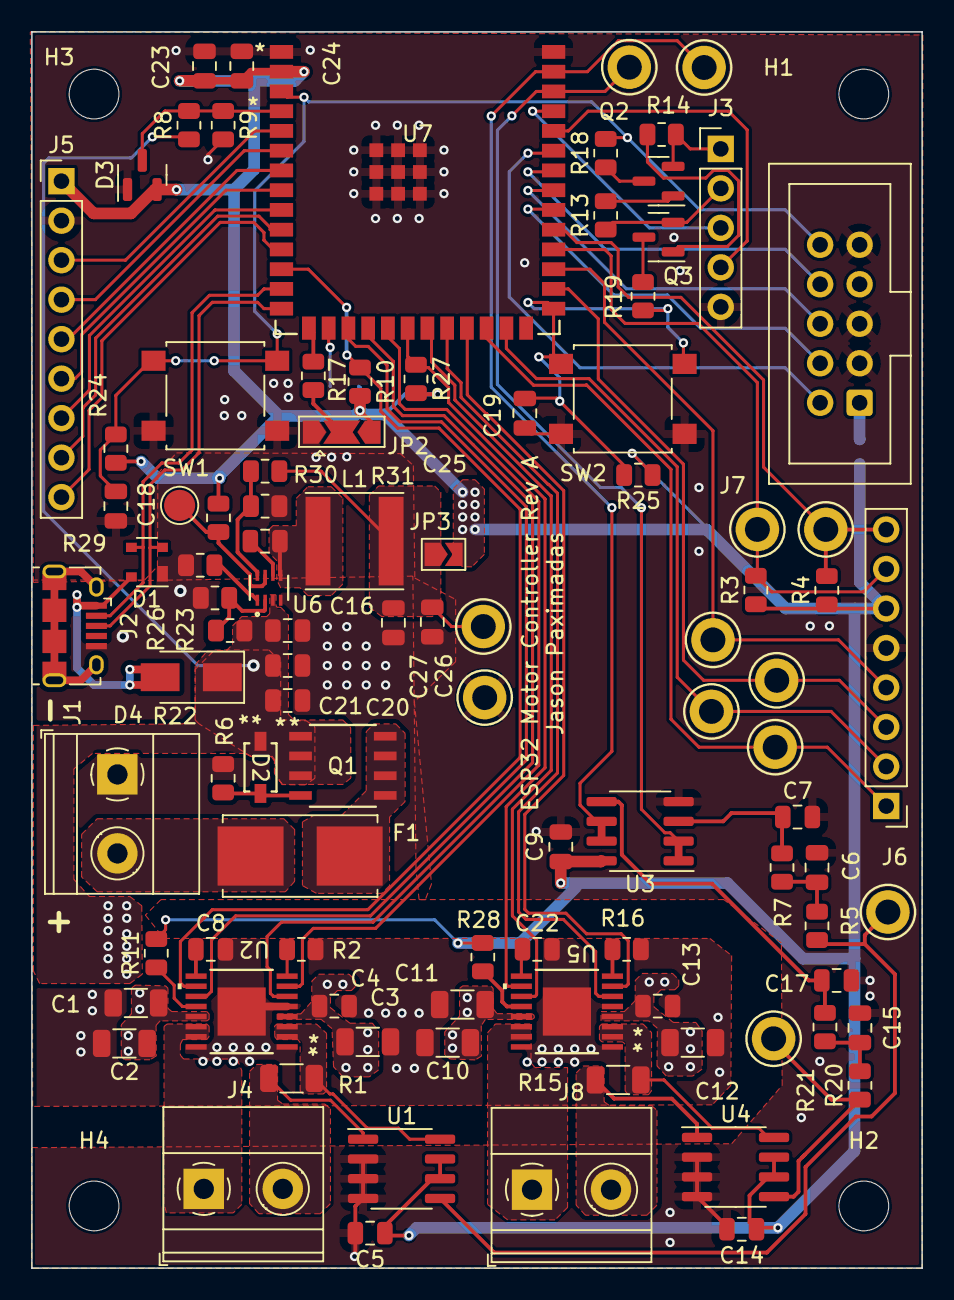
[picture p32: board esp32_example.kicad_pcb from above]

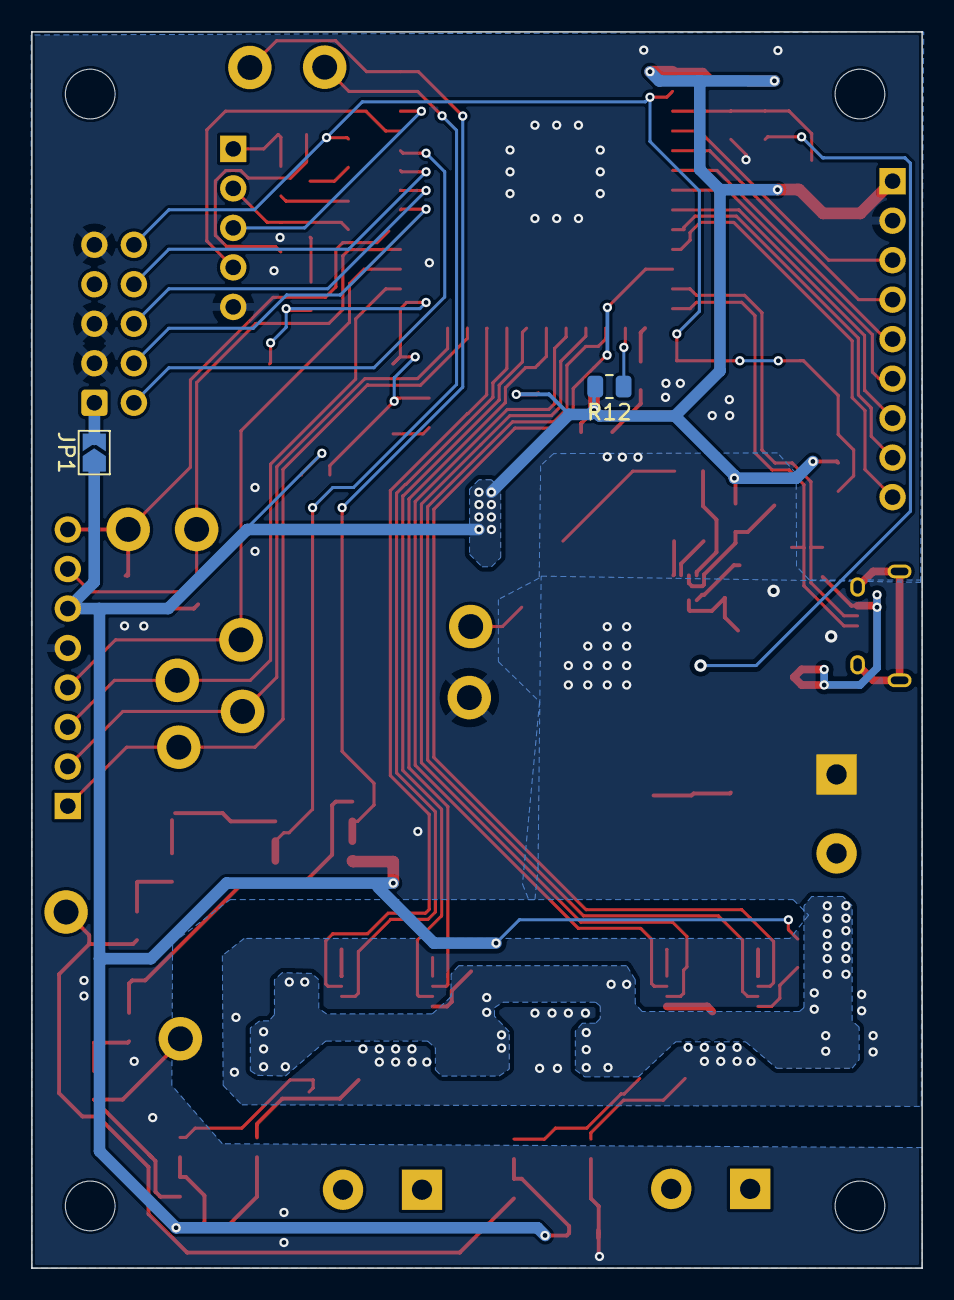
[picture p33: board esp32_example.kicad_pcb from below]

Board: 2 copper layers, 57.2 x 79.5 mm, 104 parts (2 on the bottom side), 76 nets.
