csteber02/ECE-445/(commit log)

2025-02-24 Original File Push
    [CL21B105KBFNNNG.step, Final Project V1.kicad_pcb, Final Project V1.kicad_sch, TLV75533PDBVR.step]
2025-02-27 Finish power rail
    [BQ21040DBVR.step, Final Project V1.kicad_sch]
2025-02-27 Worked on PCB
    [Final Project V1.kicad_pcb, Final Project V1.kicad_sch, UJC-HP-3-SMT-TR.step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]
2025-03-04 Finish V1 Board
    [Final Project V1-B_Cu.gbr, Final Project V1-B_Mask.gbr, Final Project V1-B_Paste.gbr, Final Project V1-B_Silkscreen.gbr, Final Project V1-Edge_Cuts.gbr, Final Project V1-F_Cu.gbr, Final Project V1-F_Mask.gbr, Final Project V1-F_Paste.gbr]
2025-03-10 Change socket headers to pins and use through-hole buttons. Need to try switch on pcb when arrives and change camera connector
    [1825910-6.step, Final Project V1.kicad_pcb, Final Project V1.kicad_sch, Fish Feeder Rotator.stl]
2025-03-28 V2 Board
    [75867-132LF.step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]
2025-03-30 Added resistors to control channel on USB-C cause I am a silly goose and didn't do that before
    [Final Project V1.kicad_pcb, Final Project V1.kicad_sch]
2025-04-11 V4 Schematic. Will work with V3
    [10118194-0001LF.step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]
